VicRoss2409/3Aproject/Codes/ReadMe

anciens codes pour piloter nos modules arduino
