VicRoss2409/3Aproject/Photos/README.md

# 📷 Images

This folder contains photos and visual materials related to the NEMO underwater robot project.

### Contents
- Prototype assembly photos
- Renders from Fusion 360
- Diagrams and technical illustrations
- Banner images for documentation and GitHub

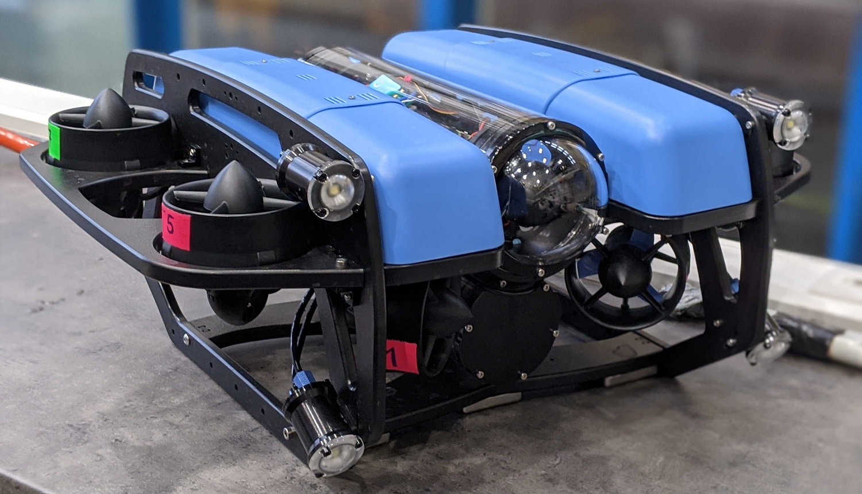
[picture p2: Photos/heavy.jpg]

NEMO ROV Banner


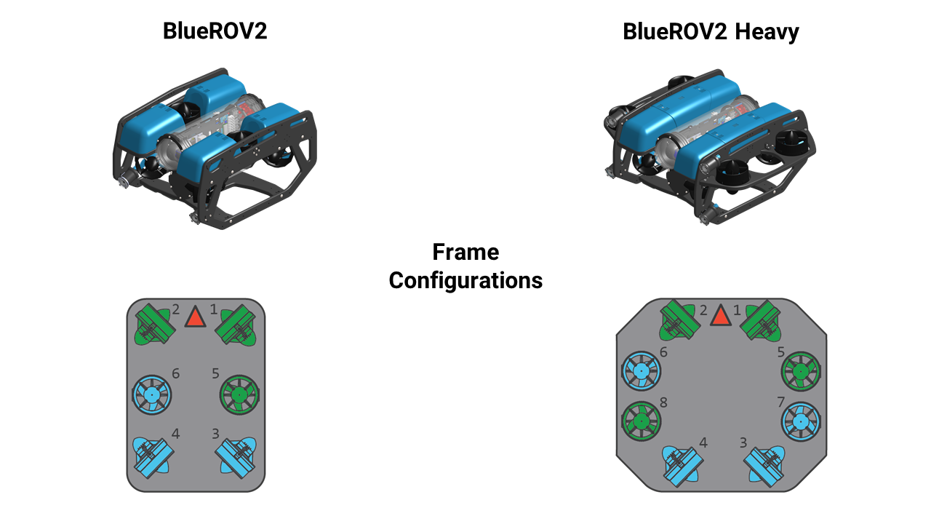
[picture p5: Photos/quick-start-br2-frames.png]
