VicRoss2409/3Aproject/Documentations/README.md

# 🌐 Web Resources & References

This folder contains a curated selection of useful web resources and documentation links that have supported the development of the NEMO underwater robot. These references include tutorials, component datasheets, design inspirations, technical documentation for the Pixhawk and ArduSub ecosystem, and underwater robotics best practices.

They were used throughout the project for:
- Mechanical and electronic design decisions
- Underwater motor selection and ESC setup
- ArduSub configuration and Pixhawk calibration
- Waterproofing techniques and ROV assembly guidelines

# 🔗 Useful Web Resources for NEMO – Coral ROV Project

## 🛠️ ROV Design & Assembly

- [BlueROV2 Build Instructions – BlueRobotics](https://bluerobotics.com/learn/bluerov2-assembly/)
- [ROV Design Guide – Marine Advanced Technology Education (MATE)](https://materovcompetition.org/)
- [OpenROV GitHub Repo](https://github.com/OpenROV/openrov-software)
- [Underwater ROV Thruster Guide – BlueRobotics](https://bluerobotics.com/learn/bluerov2-assembly/#parts-and-tools)
---

## ⚙️ Pixhawk & ArduSub Resources

- [ArduSub Official Documentation](https://www.ardusub.com/introduction/)
- [Pixhawk Hardware Overview – ArduPilot](https://ardupilot.org/copter/docs/common-pixhawk-overview.html)
- [QGroundControl – Ground Station Software](https://docs.qgroundcontrol.com/en/)
- [Pixhawk Motor Mapping for ROVs](https://www.ardusub.com/reference/frame-definitions.html)
- [ArduSub Parameter Reference](https://www.ardusub.com/developers/full-parameter-list.html)

---

## 🔌 Motors, ESCs & Waterproofing

- [How Brushless Motors Work – YouTube](https://youtu.be/CJOATX3r0Wo?si=egM10BITsuv9YJw7)
- [Understanding ESCs – BlueRobotics Guide](https://bluerobotics.com/learn/bluerov2-assembly/#electronics-enclosure-overview)
---

## 📐 Materials & Structural Design

- [PETG vs PLA for ROVs – All3DP](https://3dadvance.fr/les-filaments-standards#:~:text=PETG%20vs%20PLA&text=Le%20PETG%20est%20un%20choix,PLA%20n'est%20pas%20%C3%A9tanche.)
- [Using Epoxy for Waterproofing 3D Prints](https://3dprint.com/91543/wax-waterproof-3d-print/)
