VicRoss2409/3Aproject/Report/Weekly Report/Léo rapport de séance n°18.pdf

De Sue Léo | 2023/2024
| ROB 3
Rapport de séance n°18 :

Déroulé de la séance : - Test capteur pH
- Retouche support capteur pH
- Refonte support intérieur
- Test lampe étanche + modélisation du support

I-Capteur pH :
Au début de la séance M.Masson nous a remis une partie de la commande que nous avions passé précédemment. Dans celle-ci se trouvait le capteur pH avec son module de commande J’ai donc débuté à travailler sur son fonctionnement. La première chose à faire à été d’étalonner le module de commande sans brancher le capteur pH. En effet il fallait jouer avec le potentiomètre du module pour que la tension du module sans le capteur soit de 2.5 V, équivalent à un pH 7 à l’équilibre avec le capteur

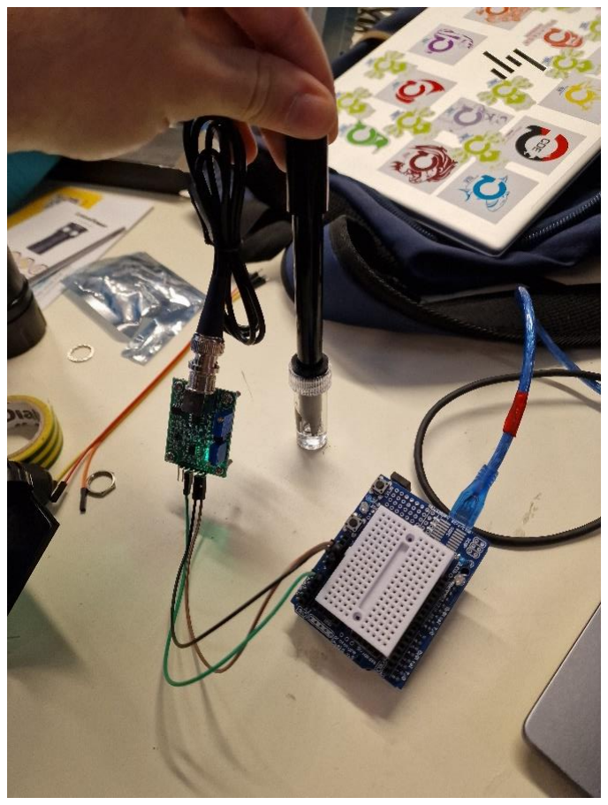
[picture p31: figure]
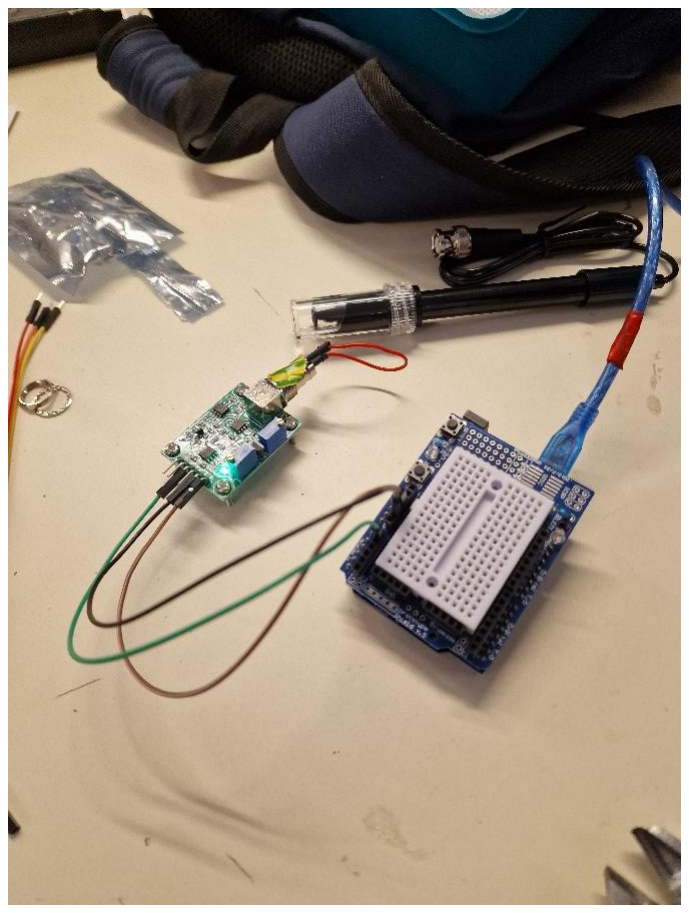
[picture p32: figure]

Initialisation du module | Branchement du capteur pH

Une fois le programme du capteur récupérer et modifier j’ai pu tester le fonctionnement du capteur dans sa solution d’eau distillée à pH, j’en ressort ses résultats concluants.

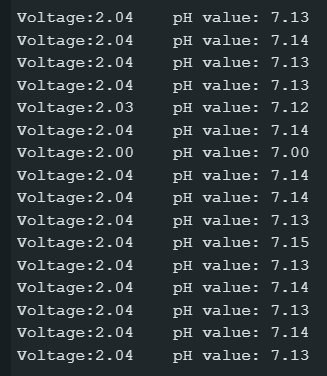
[picture p33: figure]

Test programme capteur pH

II-Retouche support capteur pH :
Au vu des nouvelles dimensions de ce capteur j’ai du légèrement modifier ma modélisation du support que j’ai ensuite lancé en impression.

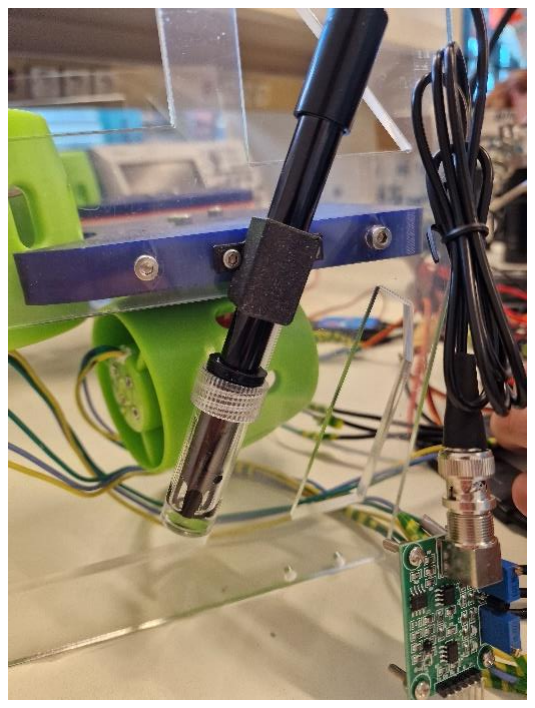
[picture p34: figure]
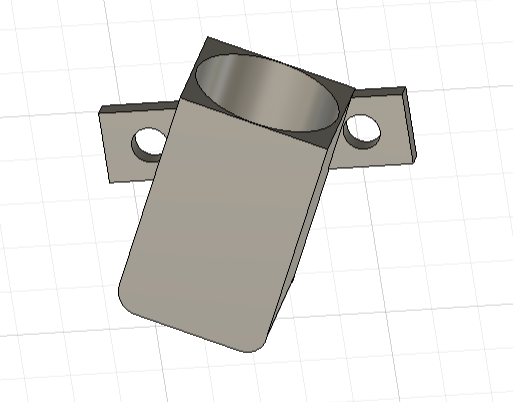
[picture p35: figure]

Modélisation du support | Résultat assemblé

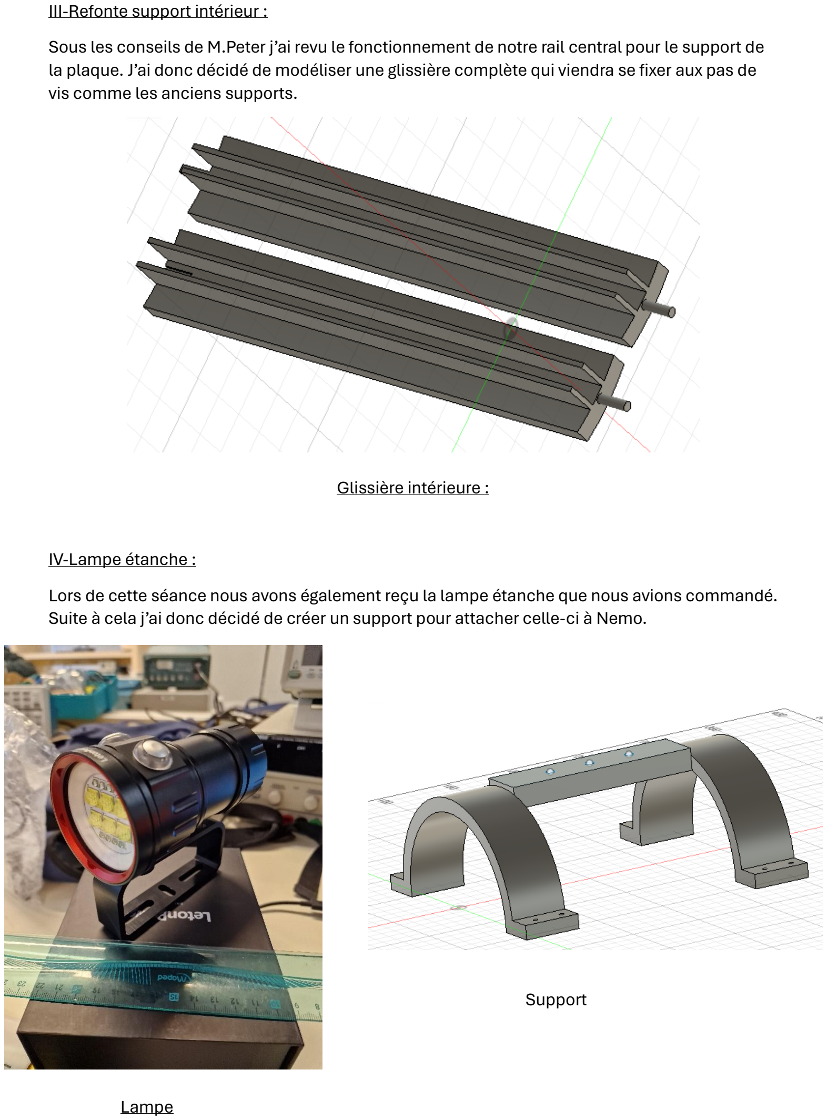
[picture p36: page 3]

III-Refonte support intérieur :
Sous les conseils de M.Peter j’ai revu le fonctionnement de notre rail central pour le support de la plaque. J’ai donc décidé de modéliser une glissière complète qui viendra se fixer aux pas de vis comme les anciens supports.

Glissière intérieure :

IV-Lampe étanche :
Lors de cette séance nous avons également reçu la lampe étanche que nous avions commandé. Suite à cela j’ai donc décidé de créer un support pour attacher celle-ci à Nemo.

Support

Lampe
