VicRoss2409/3Aproject/Report/Weekly Report/Léo rapport de séance n°16.pdf

De Sue Léo | 2023/2024
| ROB 3
Rapport de séance n°16 :

Déroulé de la séance : - Retouche du rail central
- Modélisation support capteur pH

I-Contexte : Lors de cette séance Victor ayant été absent, je me suis concentré sur des taches de modélisation pour pouvoir poursuivre le contrôle des moteurs à son retour.

II-Modélisation : J’ai apporté des changements au niveau du rail centrale car celui-ci n’était pas entièrement supporté par le rail d’un côté.

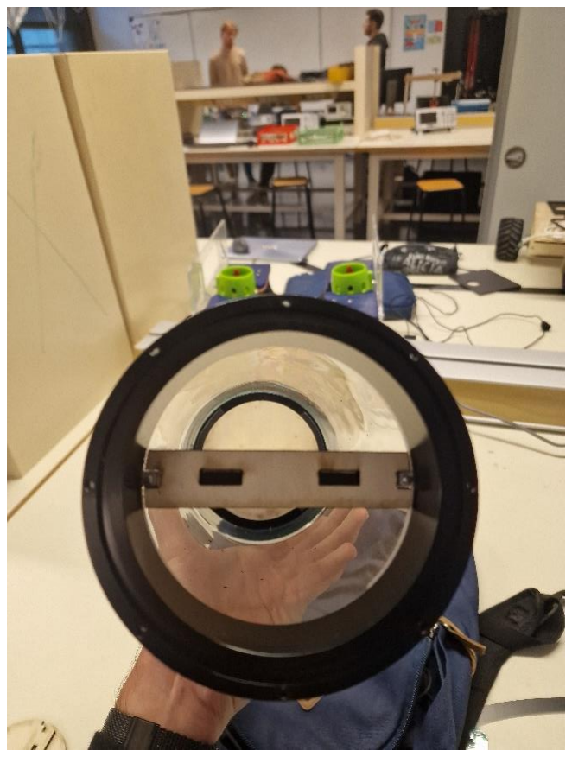
[picture p39: figure]
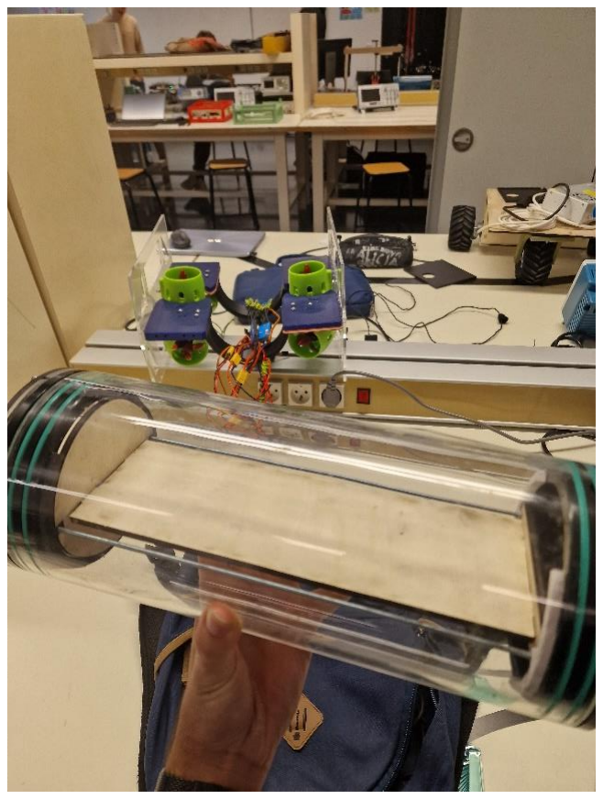
[picture p40: figure]

Conception du rail intérieure terminé

III-Modélisation : J’ai par la suite travaillé sur un prototype de support pour le capteur pH pour que celui-ci s’intègre au mieux à la structure de Nemo.

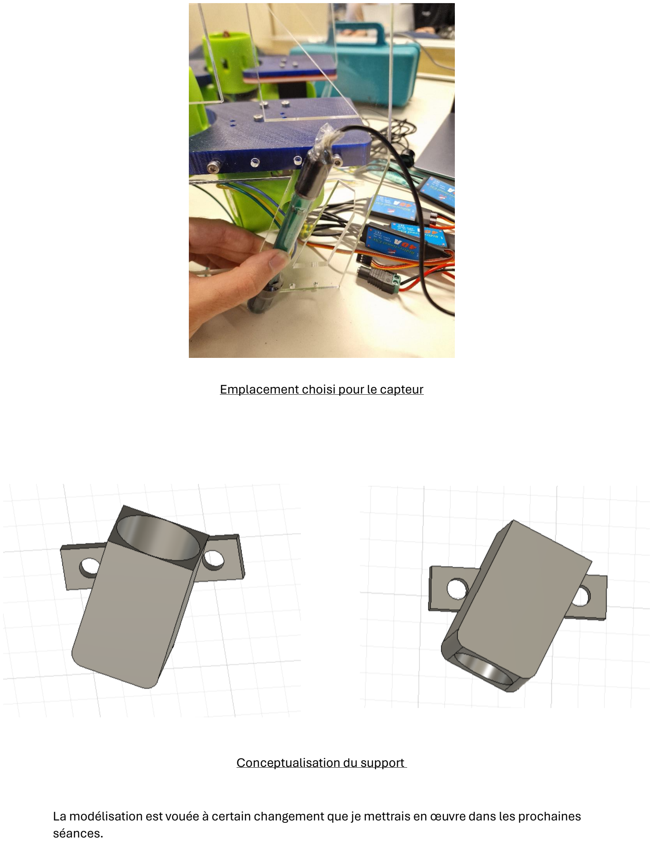
[picture p41: page 2]

Emplacement choisi pour le capteur

Conceptualisation du support

La modélisation est vouée à certain changement que je mettrais en œuvre dans les prochaines séances.
