VicRoss2409/3Aproject/Report/Weekly Report/Léo rapport de séance n°12.pdf

De Sue Léo | 2023/2024
ROB 3
Rapport de séance n°12 :

Déroulé de la séance : - Impression 3D
- Changement de stratégie

I-Impression 3D :
Au début de la séance j’ai été imprimer la pièce de support du rail centrale précédemment modélisée.

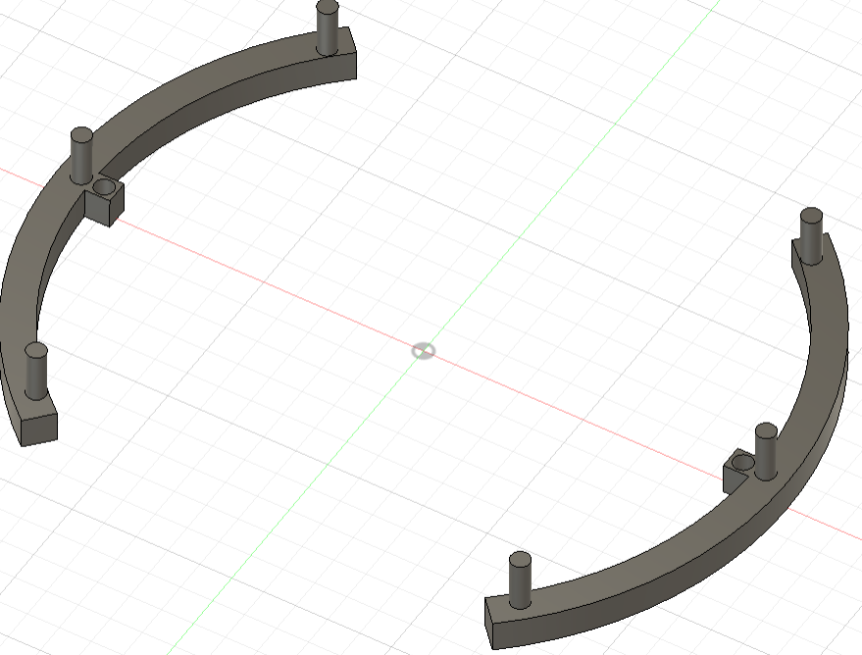
[picture p61: figure]

II-Changement au sujet d’ESPLORA :
Après en avoir discuté avec Victor nous avons décider d’abandonner la carte ESPLORA pour contrôler les moteurs. En effet au vu du nombre de moteur que nous devions contrôler, la carte ESPLORA semblait plutôt limitée au niveau de ses sorties. De plus l’utilisation de la bibliothèque de ESPLORA étant partiellement différente de celle D’ARDUINO nous aurions perdu du temps à réapprendre celle-ci.
Nous avons donc décider de réaliser notre propre manette, ce qui devrait être assez rapide et nous permettrai de passer assez vite sur le contrôle des moteurs.
Réalisation croix directionnelle :

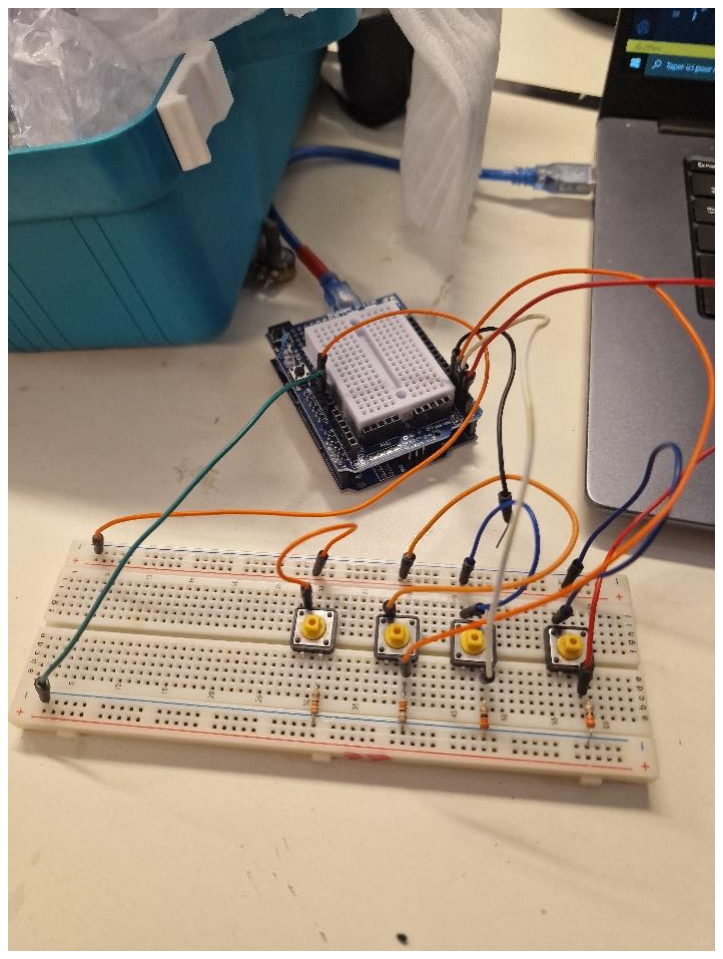
[picture p62: figure]

Test des boutons directionnels

III-Récupération impression 3D :

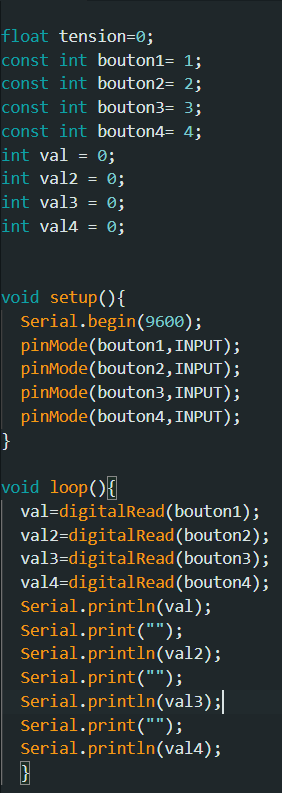
[picture p63: figure]

Une fois la pièce récupérée, j’ai remarqué que celle-ci manquait de solidité mais également que les inserts était légèrement trop large. J’ai donc modifié la manière d’impression et le diamètre des inserts.

Objectif séance suivante : - terminer la manette
- imprimer le support intérieur
