VicRoss2409/3Aproject/Report/Weekly Report/Léo rapport de séance n°10.pdf

De Sue Léo | 2023/2024
| ROB 3

Rapport de séance n°10 :

Déroulé de la séance : - Soudure des câbles moteurs aux ESC

- Recherche sur le capteur de pression
- Documentation sur ESPLORA
- Réflexion sur le tiroir central

I-Soudure :

Sous les conseils de M. Masson, nous avons entamé la soudure des câbles moteurs aux ESC pour éviter tout court-circuit à cause de mauvais branchement lors des essais sur les moteurs.

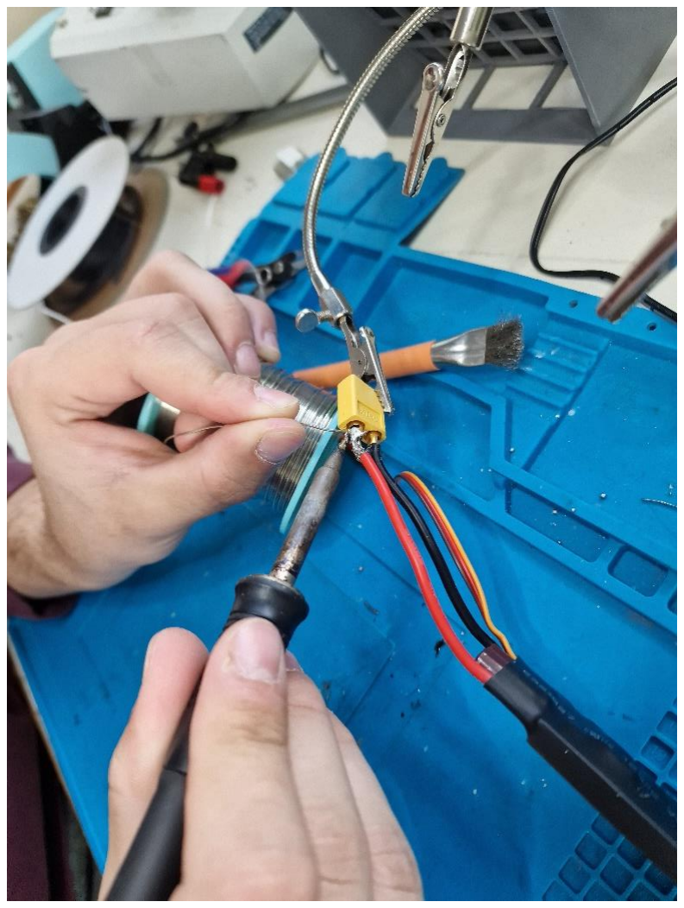
[picture p69: figure]

Soudure des différents composants

N’ayant jamais soudé, j’ai laissé Victor me montrer comment l’on s’y prenait, puis après avoir essayé, j’ai laissé la tâche à Victor pour perdre moins de temps.

II-Recherche Capteur de pression :

Pendant que Victor était occupé à souder, je me suis renseigné sur l’utilisation du capteur de pression.

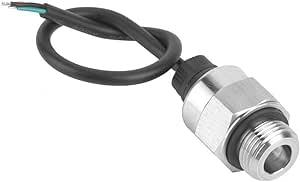
[picture p70: figure]

Capteur de pression

Après quelques recherches j’ai pu aboutir à un code Arduino permettant le contrôle de ce type de capteur, malgré tout je n’ai pas pu tester le bon fonctionnement du code car nous n’avions pas encore reçu ce capteur.

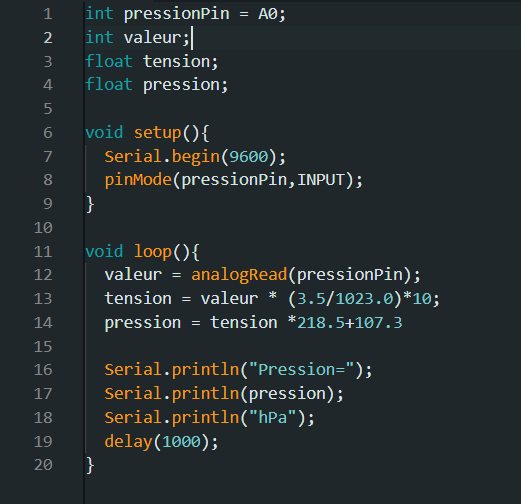
[picture p71: figure]

Code Arduino capteur de pression

Certaines valeurs seront à modifier lors de la réception du capteur pour s’adapter aux caractéristiques de celui-ci.

III-ESPLORA :

Pour simplifier le mapping des déplacements de NEMO, au lieu d’utiliser un simple joystick nous projetons d’utiliser la carte Arduino ESPLORA qui se comporte un peu comme une manette de console, disposant d’une croix directionnelle et d’un joystick.

La croix directionnelle sera affectée aux déplacements horizontaux pendant que le joystick servira aux déplacements verticaux.

Le fonctionnement de la carte étant un peu différent d’une carte Arduino classique, un peu d’adaptation fut nécessaire.

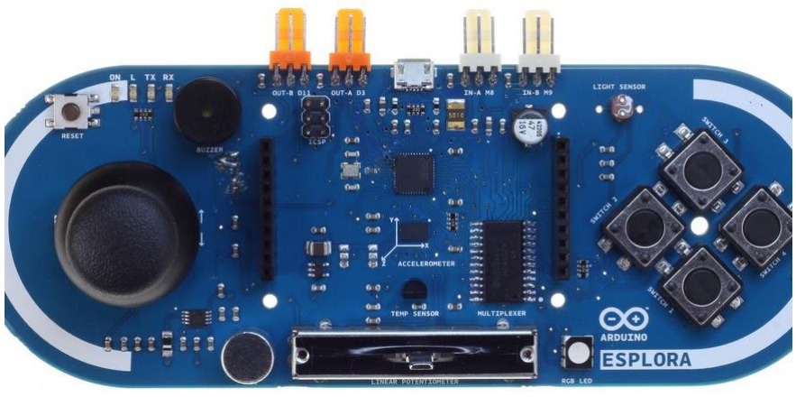
[picture p72: figure]

Carte ESPLORA

Après quelques recherches sur des forums, j’ai commencé la modification du précèdent code pour le contrôle des moteurs.

IV-Tiroir central :

Notre but est de créer un tiroir coulissant à l’intérieur du tube central pour avoir un agencement propre de la disposition de nos composants et un accès plus facile à ceux-ci.

Pour cela nous avons imaginé de disposer deux tiges filetées visées à l’intérieur du tube, agissant comme deux rails.

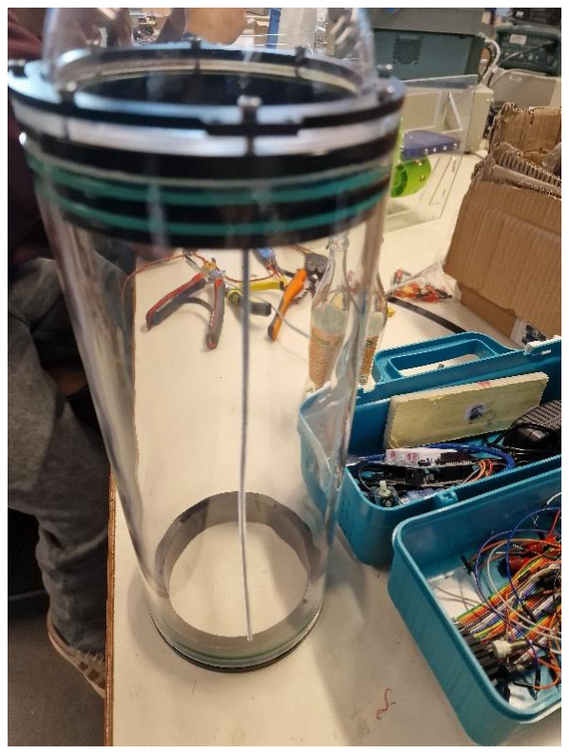
[picture p73: figure]

Disposition d’un des rails

Or au vu de la finesse des tiges (M3) nous sommes allés demander conseils à Xavier qui nous conseilla de créer deux pièces à fixer à l’intérieur du tube pour supporter et renforcer les tiges.

Objectif de la prochaine séance : - Terminer toutes les tâches évoquées précédemment
