VicRoss2409/3Aproject/Report/Weekly Report/Léo rapport de séance n°8.pdf

De Sue Léo | 2023/2024
| ROB 3

Rapport de séance n°8 :

Déroulé de la séance : - Test de fonctionnement des moteurs avec un joystick

Pendant toute la séance nous nous sommes penchés sur le contrôle des moteurs grâce à un joystick.

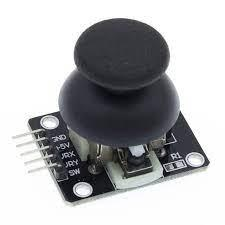
[picture p81: figure]

Joystick Arduino

1

er montage :

Dans un premier temps nous avons passé beaucoup de temps à reproduire les résultats obtenus lors de la 2ème séance. N’arrivant pas à initialiser les ESC en étant branché au générateur de tension, nous avons eu l’idée d’essayer avec des batteries mais pour éviter des soudures inutiles nous avons renoncé à l’idée.

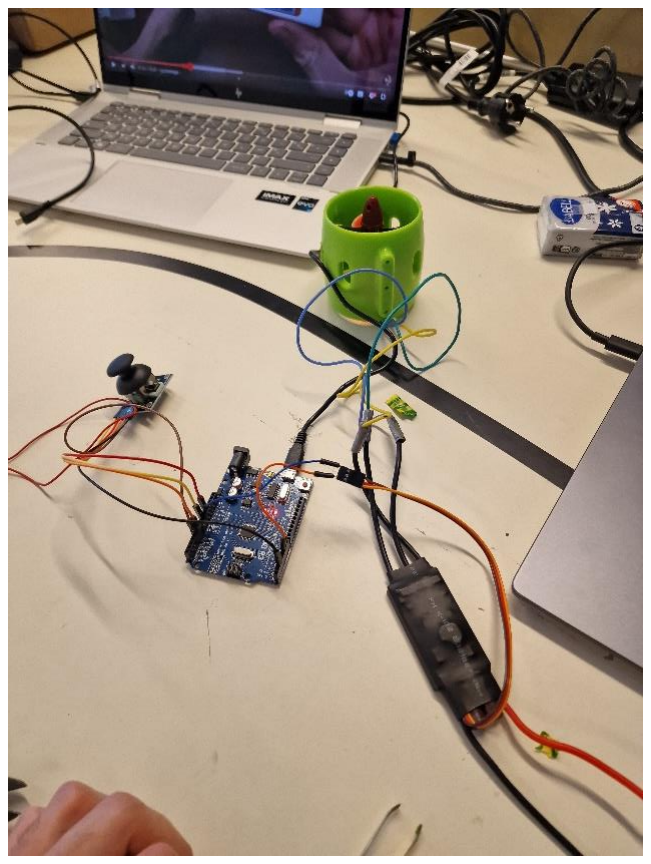
[picture p82: figure]

Montage d’un moteur
avec son ESC et le
joystick.

Résolution du problème d’initialisation :

Après avoir demandé conseil à M. Masson et M. Peter nous avons pu déterminer la source du problème qui le réglage de la tension maximal envoyée par le générateur qui était trop faible.

Dès lors après avoir changé ces valeurs les ESC ont pu être initialisés et les moteurs contrôlés par le joystick.

Partie code Arduino :

Grâce au code précédemment réalisé par Victor nous avons pu actionner un moteur uniquement lorsque le joystick étant poussé vers le haut suivant l’axe X, la vitesse de rotation de celui-ci changeant suivant la course du joystick.

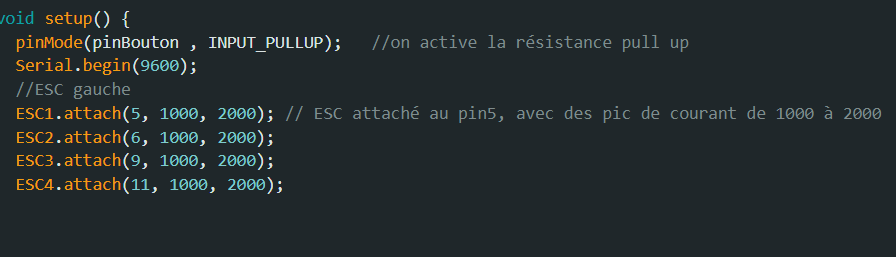
[picture p83: figure]

Initialisation des ESC :

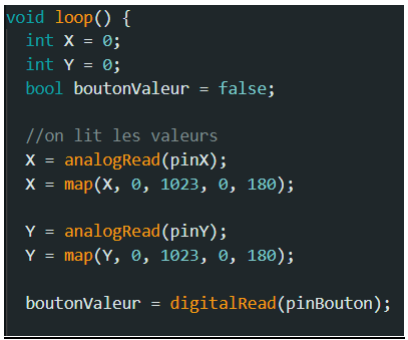
[picture p84: figure]

Mapping du joystick

Après avoir obtenu des résultats concluants avec 1 moteur nous avons ensuite branché les 4 moteurs, simulant les moteurs horizontaux de Nemo.

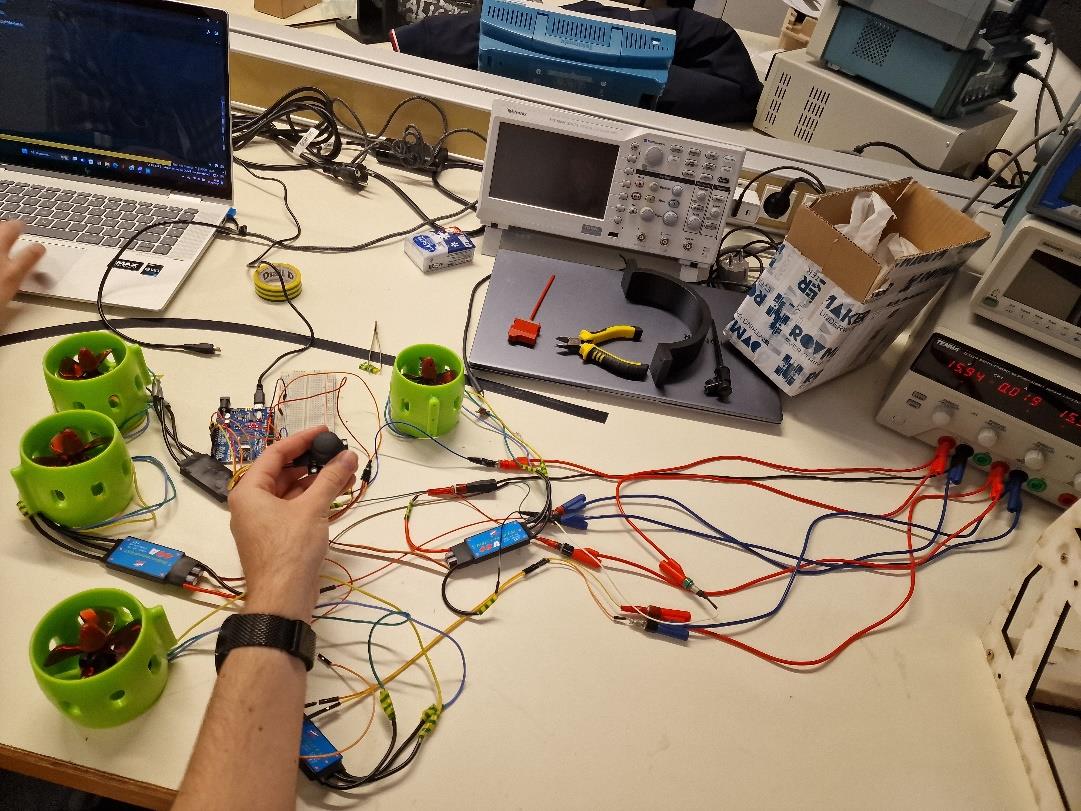
[picture p85: figure]
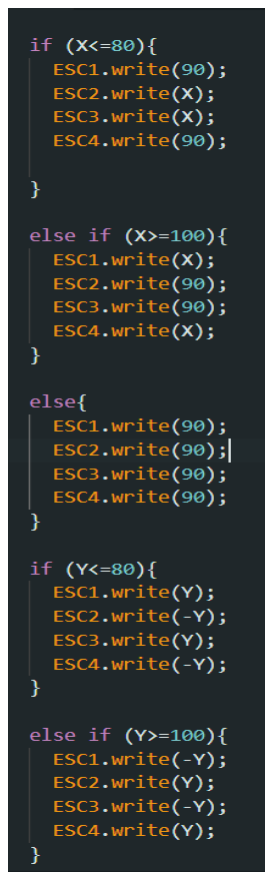
[picture p86: figure]

Vers la fin de la séance nous avons modifié le code de Victor pour créer des conditions d’activations des moteurs. Par exemple si le joystick était actionné vers la gauche suivant l’axe Y, représentant l’action de tourner vers la gauche, alors le moteur avant et arrière gauche doivent s’actionner.

Objectif prochaine séance : - Amélioration du programme

- Test avec 6 moteurs
