VicRoss2409/3Aproject/Report/Weekly Report/Victor's report n°12.pdf

Victor Rossignol | ROBO3 2023-2024
Weekly Report n°12 :

Déroulement séance :
- Conception + impression.
- Réflexion sur un nouveau moyen de commande électronique.

En début de séance nous avons imprimé la pièce conçue à la séance précédente, destinée à être un support pour des rails dans le boitier électronique.

Figure 1 : Conception Pièce.

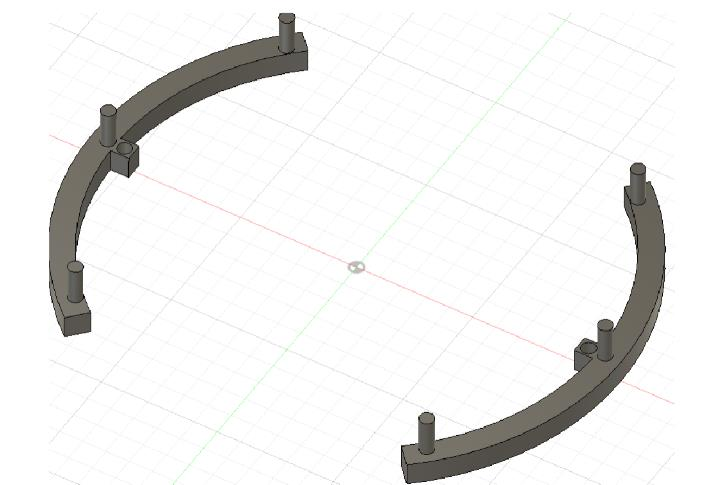
[picture p141: figure]

En voulant par la suite avancer le code, nous nous sommes rendu compte que l’utilisation de la carte Arduino Esplora n’était pas optimale pour notre projet. En effet cette dernière ne comprend que 4 ports output, or il nous en faudrait 6. Nous avons donc fait le choix de débuter la création de notre manette, à l’aide d’une breadboard, de boutons poussoirs et de fils de connexion.

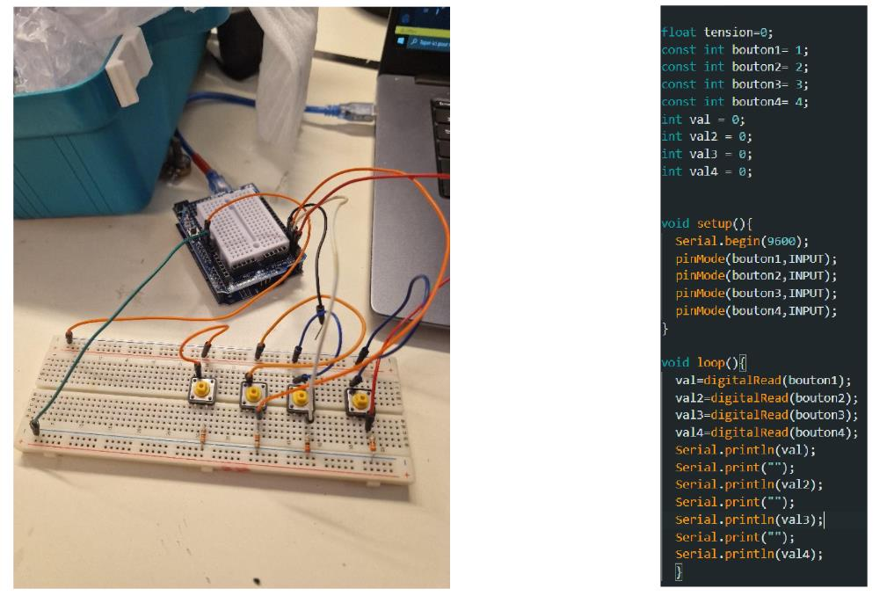
[picture p142: figure]

Figure 2 : conception + code manette.
