VicRoss2409/3Aproject/Report/Weekly Report/Victor's report n°7.pdf

ROSSIGNOL Victor | ROBO3 2023/2024

Weekly report n°7 :

Déroulement de la séance :

- Test d’étanchéité de notre capteur ultrason
- Découpe laser
- Soudure
- Codage des moteurs avec joystick

Durant le début de la séance, j’ai continué mon travail sur la découpe laser, qui vise à obtenir les parties latérales et inférieures de notre robot, j’ai ensuite lancé l’impression de notre dernière pièce permettant de fixer le cylindre.

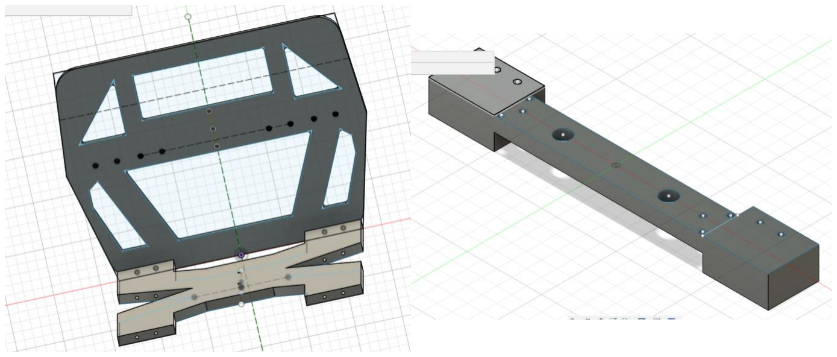
[picture p147: figure]

Figure 1 : Visualisation des pièces.

Lors de ces tâches Léo a réalisé en parallèle le code du capteur ultrason, nous l’avons ensuite testé dans l’évier du FABLAB. Nous avons constaté qu’il fonctionnait parfaitement dans l’eau et qu’il sera un outil tout à fait convenable pour NEMO.

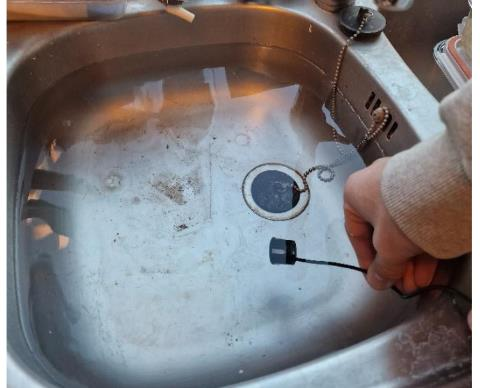
[picture p148: figure]

Figure 2 : test du capteur ultrason.

Suite à cela j’ai réalisé des soudures sur nos 4 moteurs horizontaux, puis posé une gaine
thermoformée sur ces dernières afin d’étanchéifier le tout.

Puis j’ai commencé le code pour la direction des moteurs à l’aide d’un joystick, il nous en faudra deux, un qui dirigera les mouvements horizontaux (avant, arrière, gauche, droite), un qui dirigera les mouvements verticaux (haut, bas).

A l’aide de vidéos et des cours j’ai réalisé ce premier programme :

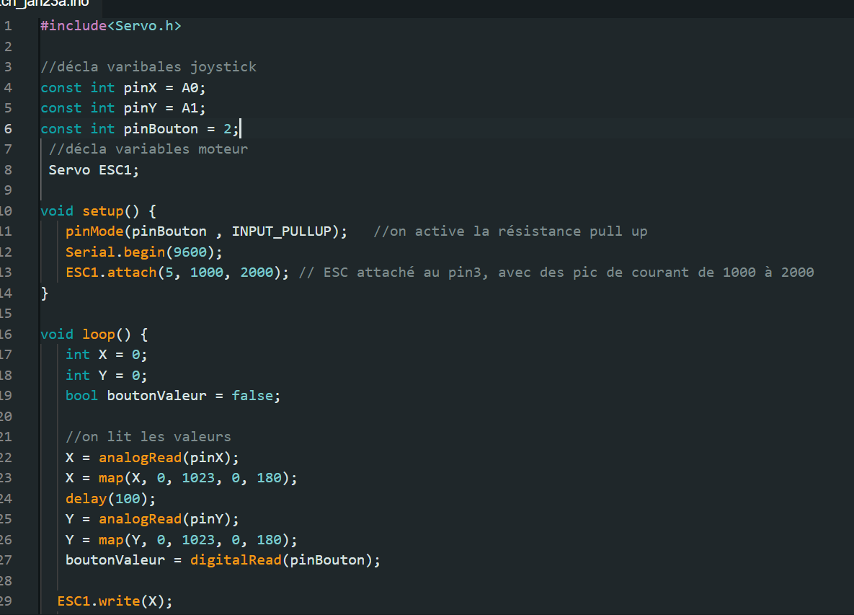
[picture p149: figure]

Figure 3 : Code pour un moteur.

Le travail reste à poursuivre là-dessus la semaine prochaine.

Pour la prochaine séance :

- Continuer le code.
- Etudier les problèmes d’étanchéité.
