VicRoss2409/3Aproject/(list of files, cad)

Other CAD files:
CAD/boite Pixhawk.f3d
