VicRoss2409/3Aproject/Photos/20240528_134857.jpg

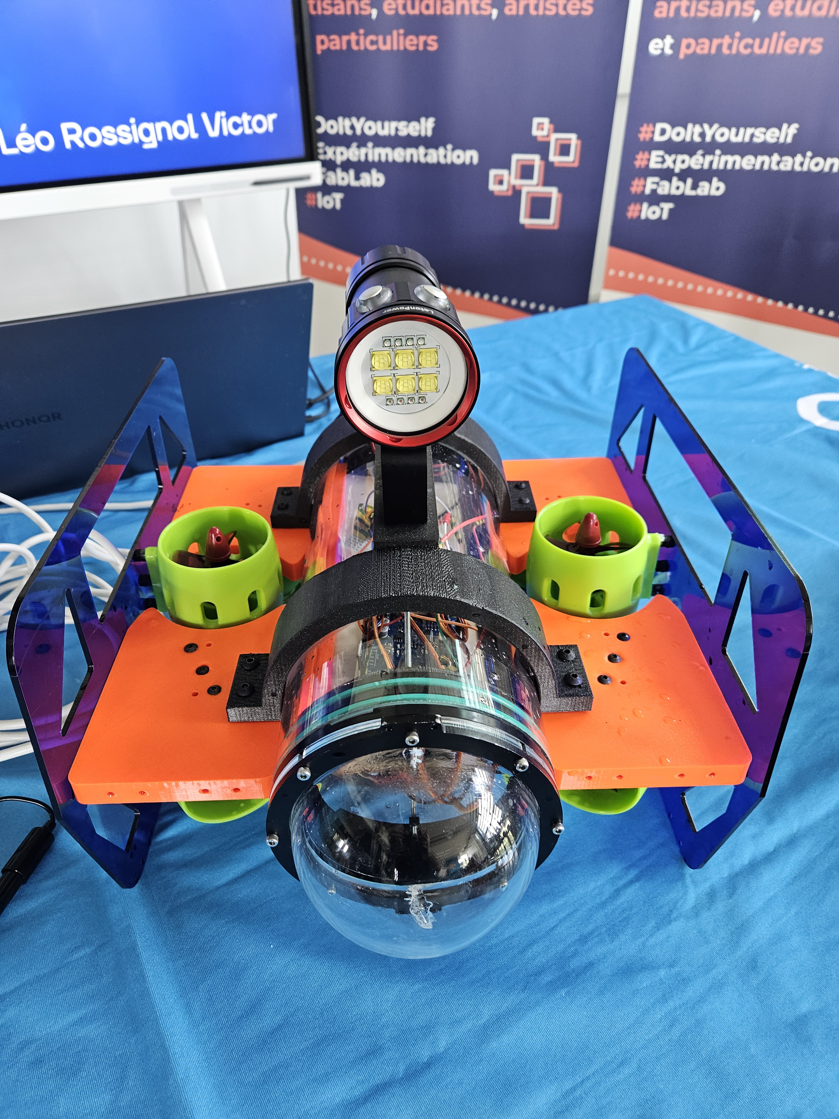
[picture p3: Photos/20240528_134857.jpg]
Photos/20240528_134857.jpg
