VicRoss2409/3Aproject/Photos/20250407_130601.jpg

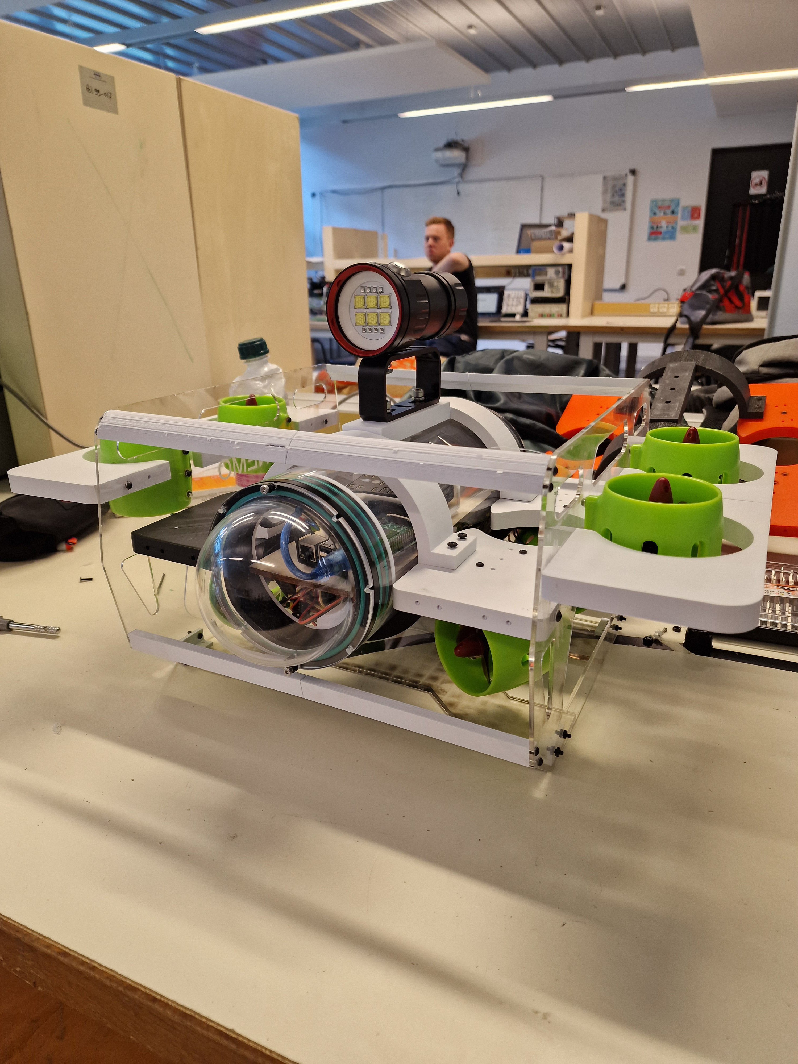
[picture p4: Photos/20250407_130601.jpg]
Photos/20250407_130601.jpg
